G-marco96/DCI/Documentos/Subpartes/Capturas/Ejemplos/Captura CAN.PNG

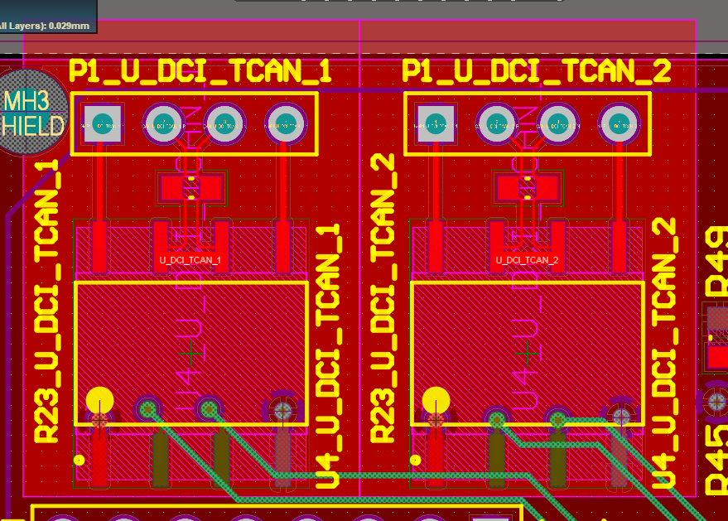
Documentos/Subpartes/Capturas/Ejemplos/Captura CAN.PNG
