G-marco96/DCI/Documentos/Subpartes/Capturas/Captura rooms.PNG

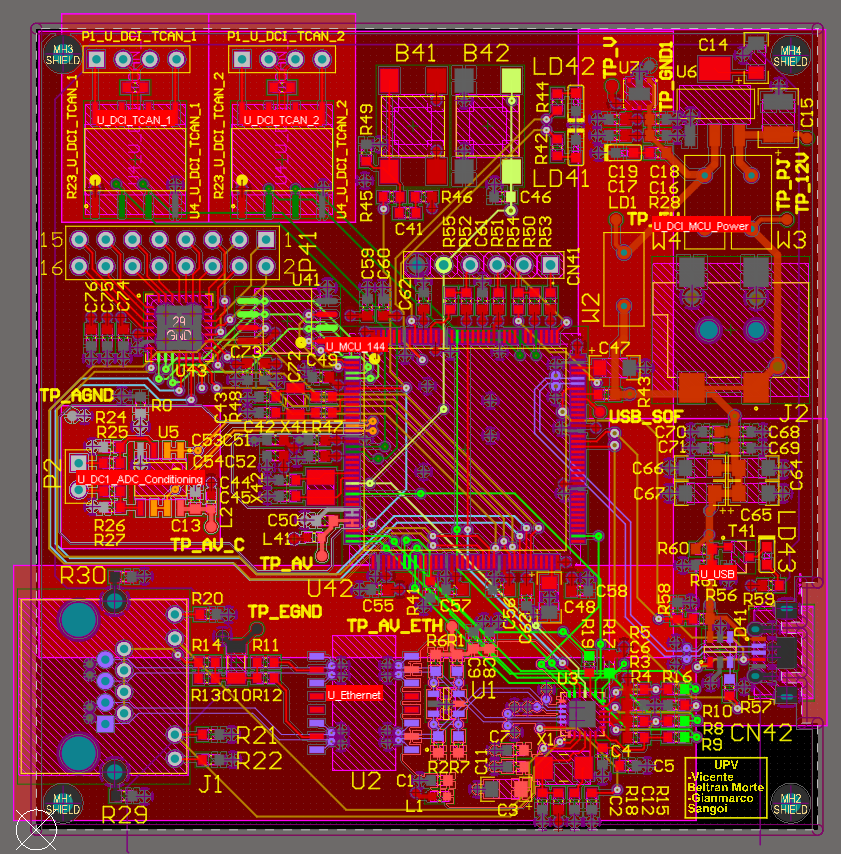
Documentos/Subpartes/Capturas/Captura rooms.PNG
