G-marco96/DCI/README.md

# Master en Sisemas Electronicos (Digital)

Materia: Diseño de Cirucitos Impresos (DCI)

Proyecto: Proyecto final de curso

Integrantes: Gianmarco Sangoi y Vicent Beltrán 

Fecha de inicio: 5/14/2022
