G-marco96/DCI/en.nucleo_144pins_sch/NUCLEO-144pins_Altium_Schematics-Layout/Project Outputs for Nucleo_144/DCI_MB1137.xls

Board Stack Report
Stack Up |  | Layer Stack
Layer | Board Layer Stack | Name | Material | Thickness | Constant
1 |  | Top Paste
2 |  | Top Overlay
3 |  | Top Solder | SM-001 | 0,025mm | 4
4 |  | Top Layer | Copper | 0,018mm
5 |  | Dielectric 2 | PP-018 | 0,152mm | 4,3
6 |  | GND | Copper | 0,035mm
7 |  | Dielectric 3 | Core-028 | 0,254mm | 4,3
8 |  | Top Internal | Copper | 0,018mm
9 |  | Dielectric 4 | PP-017 | 0,130mm | 4,3
10 |  | Dielectric 5 | PP-017 | 0,130mm | 4,3
11 |  | Bottom Internal | Copper | 0,018mm
12 |  | Dielectric 6 | Core-028 | 0,254mm | 4,3
13 |  | VDD | Copper | 0,035mm
14 |  | Dielectric 7 | PP-018 | 0,152mm | 4,3
15 |  | Bottom Layer | Copper | 0,018mm
16 |  | Bottom Solder | SM-001 | 0,025mm | 4
17 |  | Bottom Overlay
18 |  | Bottom Paste
 | Height : 1,263mm
