G-marco96/DCI/Documentos/6layers_1.6mm_LabCode424.pdf

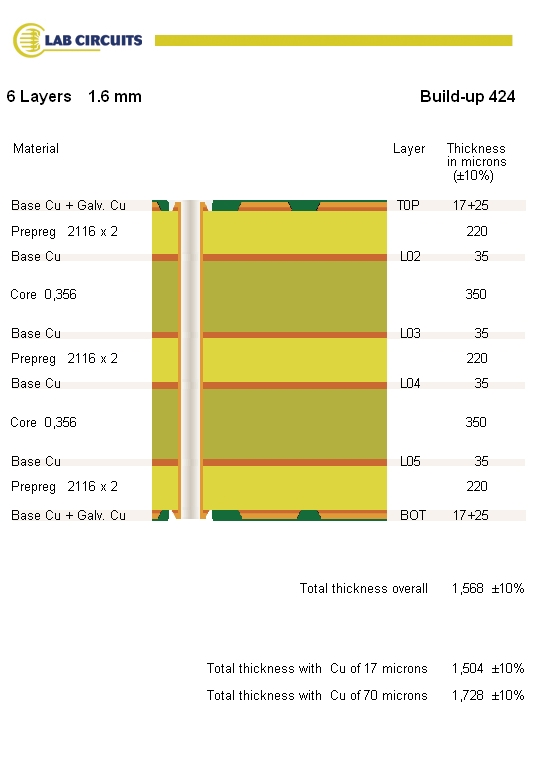
[picture p35: page 1]
