G-marco96/DCI/Documentos/Subpartes/Capturas/Captura Forma placa.PNG

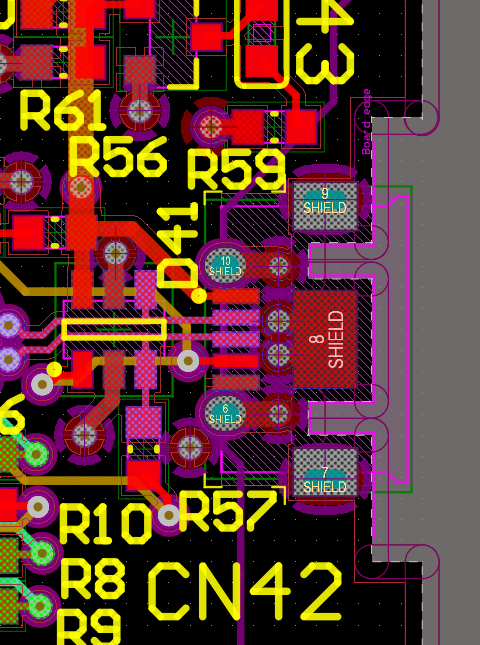
Documentos/Subpartes/Capturas/Captura Forma placa.PNG
