G-marco96/DCI/Documentos/Subpartes/Capturas/Captura Layer 3D.PNG

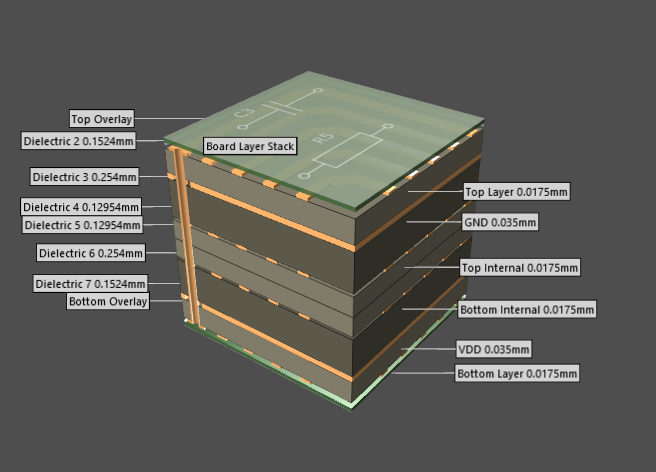
Documentos/Subpartes/Capturas/Captura Layer 3D.PNG
