G-marco96/DCI/Documentos/Subpartes/Capturas/Captura VDD.PNG

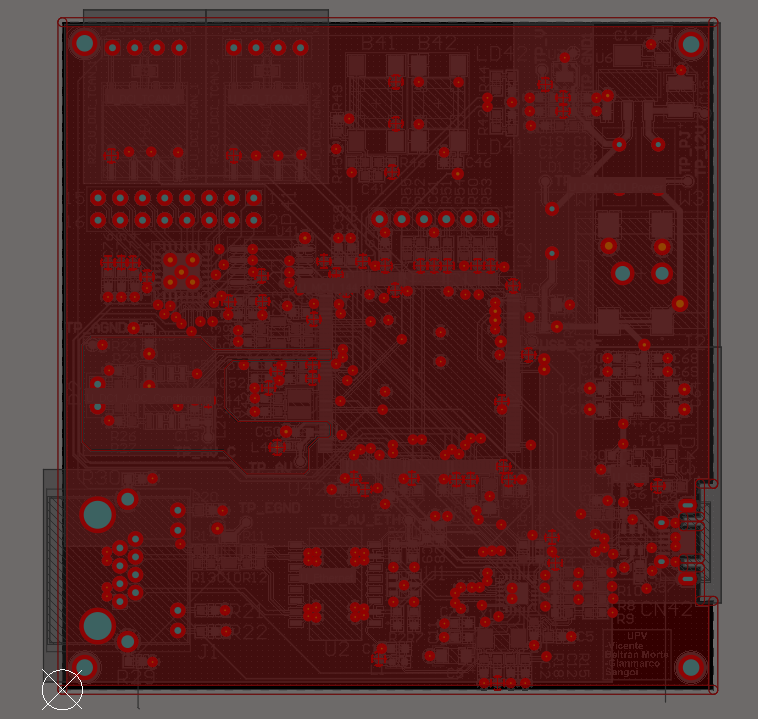
Documentos/Subpartes/Capturas/Captura VDD.PNG
