G-marco96/DCI/Documentos/Subpartes/Capturas/Ejemplos/Captura condensador modificado.PNG

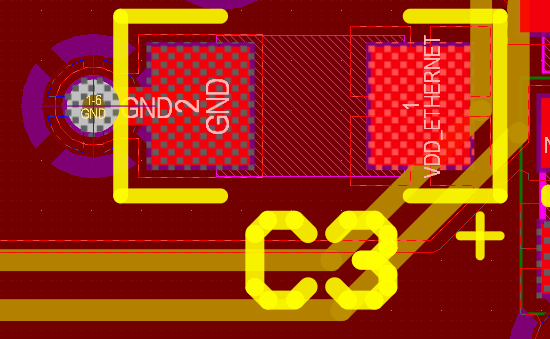
Documentos/Subpartes/Capturas/Ejemplos/Captura condensador modificado.PNG
