G-marco96/DCI/Documentos/Subpartes/Capturas/Ejemplos/Captura Label style.PNG

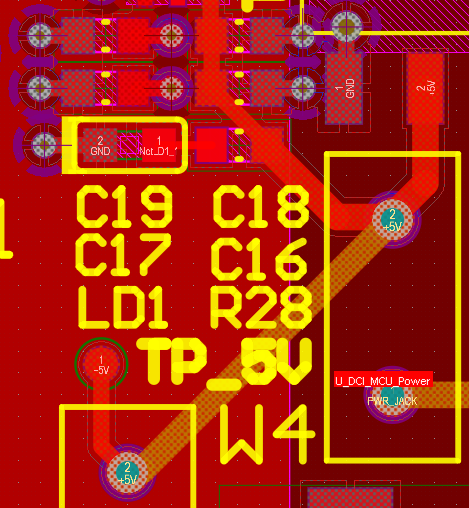
Documentos/Subpartes/Capturas/Ejemplos/Captura Label style.PNG
