G-marco96/DCI/Documentos/Subpartes/Capturas/Ejemplos/Captura vias u43.PNG

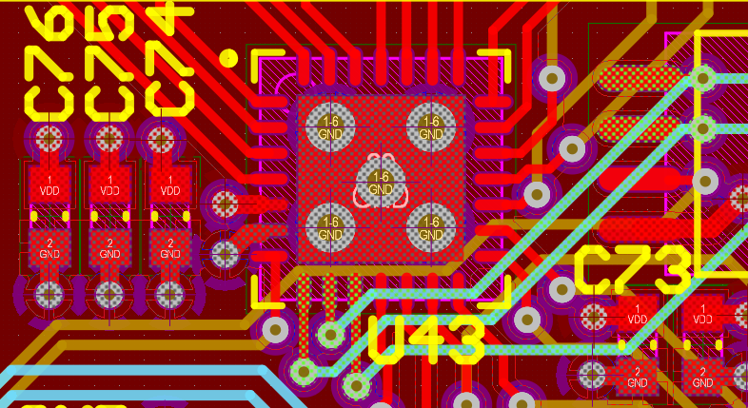
Documentos/Subpartes/Capturas/Ejemplos/Captura vias u43.PNG
