G-marco96/DCI/Documentos/Subpartes/Capturas/Texto sacrificable.PNG

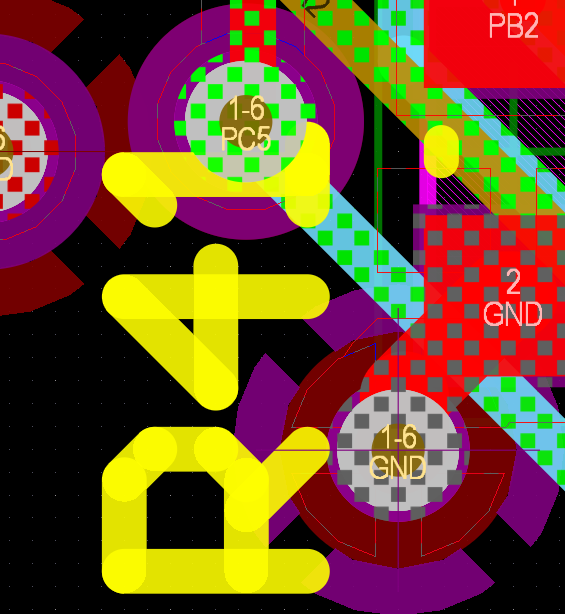
Documentos/Subpartes/Capturas/Texto sacrificable.PNG
