G-marco96/DCI/en.nucleo_144pins_sch/NUCLEO-144pins_Altium_Schematics-Layout/Project Outputs for Nucleo_144/BillOfMaterials.PDF

Comment | Description | Designator | Footprint | LibRef | Quantity
USER (Blue) | SE PUSHBUTTON | B41 | PB-6X6mm-Blue | SW PUSHBUTTON | 1
TD-0341 [RESET/Black] | SE PUSHBUTTON | B42 | PB-6X6mm-Black | SW PUSHBUTTON | | 1
100nF | Capacitor 0402 / 0603 / 0805, Capacitor | C1, C6, C7, C8, C9, C11, C13, C18, C19, C46, C50, C51, C52, C53, C54, C55, C56, C57, C58, C59, C60, C61, C62, C68, C69, C70, C71, C72, C73, C74, C75 | 0603C | Capacitor_ST, Cap | 31
30pF | Capacitor 0402 / 0603 / 0805 | C2, C12 | 0603C | Capacitor_ST | | 2
10uF | Polarized Capacitor,10uF,10V,1 0%,typeA,VISHAY, Polarized Capacitor (Radial) | C3, C14 | TAN-A - XDown | Cap_10uF_POL_10%_ TANA, Cap Pol1 | | 2
470pF | Capacitor 0402 / 0603 / 0805 | C4 | 0603C | Capacitor_ST | | 1
1uF_X5R | 0603 X5R 1µF | C5, C16, C17, C49 | 0603C | CAP SMD 0603 X5R 1µF 25V 10% | | 4
TC1206KKX7RDBB102 | Capacitor 0402 / 0603 / 0805/ 1206 | C10 | 1206C | Capacitor_ST | | 1
10uF(25V) | Polarized Capacitor (Radial) | C15 | TAN-B | Cap Pol1 | | 1
[N/A] | Capacitor | C41 | 0603C | CAP | | 1
2pF | Capacitor | C42, C43 | 0603C | CAP | | 2
4.3pF[N/A] | Capacitor | C44, C45 | 0603C | CAP | | 2
2.2uF_X7R | Capacitor,2.2uF,16V, X7R,10%,0805,YAGEO | C47 | TAN-A - XDown | Cap_2.2uF_X7R_10%_ 0805 | | 1
2.2uF_X7R | Capacitor,2.2uF,16V, X7R,10%,0805,YAGEO | C48 | TAN-A - XUp | Cap_2.2uF_X7R_10%_ 0805 | | 1
4.7uF_X5R_0603 | 0603 X5R 4.7uF | C63, C76 | 0603C | CAP SMD 0603 X5R 1µF 25V 10% | | 2
4.7uF | Polarized Capacitor (Radial) | C64, C66 | TAN-A - XNo | Cap Pol1 | | 2
4.7uF | Polarized Capacitor (Radial) | C65 | TAN-A - XUp | Cap Pol1 | | 1
4.7uF | Polarized Capacitor (Radial) | C67 | TAN-A - XDown | Cap Pol1 | | 1
SWD_Header | Header, 6-Pin, Single row | CN41 | HDR_1x6_2R54_V_M | Header 6X1 | | 1
475900001 | | CN42 | MOLEX_47590001 | 475900001 | | 1
ESDA6V1BC6 | 4-line ESD protection | D41 | SOT23-6L | ESDA6V1BC6 | | 1
RJHSE-5381 | High Speed RJ45, Modular Jack, 8 Position, 8 Contacts, Shielded, with LEDs, -55 to 85 degC,12-Pin THD, RoHS, Tray | J1 | AMPH-RJHSE-5381_V | CMP-2000-06980-1 | | 1
Power_Connector | DC Power Jack, Right Angle, -25 to 85 degC, 4-Pin 14.8 x 9 x 11mm SMD, RoHS, Tape and Reel | J2 | CUI-PJ-002AH-4_V | CMP-2000-06896-1 | | 1
BEAD | Inductor | L1, L2, L41 | 0603L | Inductor | | 3
Green | Typical RED, GREEN, YELLOW, AMBER GaAs LED | LD1, LD43 | 0603D-G | LED2 | | 2
Blue | Typical RED, GREEN, YELLOW, AMBER GaAs LED | LD41 | 0603D-B | LED2 | | 1
Red | Typical RED, GREEN, YELLOW, AMBER GaAs LED | LD42 | 0603D-R | LED2 | | 1
CAN_Header | Header, 4-Pin | P1_U_DCI_TCAN_1, P1_U_DCI_TCAN_2 | HDR1X4 | Header 4 | | 2
ADC_Header | Header, 2-Pin | P2 | HDR1X2 | Header 2 | | 1
Header 8X2 | Header, 8-Pin, Dual row | P41 | HDR2X8 | Header 8X2 | | 1
0 | Resistor, Resistor 0402 / 0603 / 0805 | R0, R29, R30, R47, R48, R53 | 0603R | res1, Resistor_ST | | 6
50 | Resistor,50,0603,1%,Y AGEO | R1, R2, R6, R7 | 0603R | Res_50_1%_0603 | | 4
10K | Resistor 0402 / 0603 / 0805, Resistor | R3, R4, R5, R10, R18, R21, R25, R27, R43, R50, R51, R52 | 0603R | Resistor_ST, Res1 | 12
33 | Resistor,33,0402,1%,Y AGEO | R8, R9, R16, R19 | 0603R | Res_33_1%_0402 | | 4
75 | Resistor,75,0603,1%,Y AGEO | R11, R12, R13, R14 | 0603R | Res_75_1%_0603 | | 4
12K1 | Resistor,12K1,0603,1 %,VISHAY | R15 | 0603R | Res_12K1_1%_0603 | | 1
1K5 | Resistor,1K5,0402,1%, YAGEO, Resistor 0402 / 0603 / 0805 | R17, R57 | 0603R | Res_1K5_1%_0402, Resistor_ST | | 2
270 | Resistor 0402 / 0603 / 0805 | R20, R22 | 0603R | Resistor_ST | | 2
120 | Resistor | R23_U_DCI_TCAN_1, R23_U_DCI_TCAN_2 | 0603R | Res1 | | 2
22K | Resistor | R24, R26, R61 | 0603R | Res1 | | 3
1K | Resistor 0402 / 0603 / 0805, Resistor | R28, R44 | 0603R | Resistor_ST, Res1 | | 2
100K | Resistor | R41 | 0603R | res1 | | 1
680 | Resistor | R42 | 0603R | Res1 | | 1
330 | Resistor | R45, R59 | 0603R | Res1 | | 2
100 | Resistor | R46 | 0603R | Res1 | | 1
220K | Resistor | R49 | 0603R | res1 | | 1
22 | Resistor 0402 / 0603 / 0805 | R54, R55 | 0603R | Resistor_ST | | 2
430K | Resistor | R56 | 0603R | res1 | | 1
620K | Resistor | R58 | 0603R | res1 | | 1
47K | Resistor | R60 | 0603R | res1 | | 1
9013 | NPN Bipolar Transistor | T41 | SOT-23 | NPN | | 1
TP_5V | | TP_5V | TP | TP | | 1
TP_12V | | TP_12V | TP | TP | | 1
TP_AGND | | TP_AGND | TP | TP | | 1
TP_AVDD | | TP_AV | TP | TP | | 1
TP_AVDD_C | | TP_AV_C | TP | TP | | 1
TP_AVDD_ETH | | TP_AV_ETH | TP | TP | | 1
TP_EGND | | TP_EGND | TP | TP | | 1
TP_GND | | TP_GND1 | TP | TP | | 1
TP_PJ | | TP_PJ | TP | TP | | 1
TP_VDD | | TP_V | TP | TP | | 1
USBLC6-4SC6 | | U1 | SOT23-6L | USBLC6-4SC6 | | 1
KMS-1102NL | | U2 | Transformer | KMS-1102NL | | 1
LAN8742A-CZ-TR | LAN8742A-CZ-TR -Small Footprint RMII 10/100 Ethernet, Transceiver with HP Auto-MDIX and flexPWR Technology SQFN-24 | U3 | QFN24_0R5_4X4 | LAN8742A-CZ-TR | | 1
ISO1050DUBR | Isolated CAN Transceiver, -55 to 105 degC, 8-pin SOP (DUB), Green (RoHS & no Sb/Br) | U4_U_DCI_TCAN_1, U4_U_DCI_TCAN_2 | DUB0008A_L | CMP-0315-00093-2 | | 2
MC33077DR2G | Low Noise Dual Operational Amplifier, 5 to 36 V, -40 to 85 degC, 8-Pin SOIC, Pb-Free, Tape and Reel | U5 | ONSC-SOIC-8-751-07_V | CMP-1310-00366-1 | | 1
LD1117S50TR | | U6 | SOT-223 | LD1117 | | 1
LD39050PU33R | | U7 | DFN6_0R95_3x3_TP | LD39050P | | 1
M25P16-VMW6G | 16 Mb (x1) Serial NOR Flash Memory, 75 MHz, 2.7 to 3.6 V, 8-pin SO8 Wide (MW), Tube | U41 | MICT-MW-8_N | CMP-0357-00145-1 | | 1
MCU_LQFP144 | | U42 | TSQFP50P2200X2200X 160-144N | MCU_LQFP144 | | 1
MCP23S17T-E/ML | 16 output GPIO expander | U43 | QFN-ML28_L-Improved_Holes | MCP23S17T-E/ML | | 1
USB_SOF | | USB_SOF | TP | TP | | 1
Jumper_USB | Jumper Wire | W2 | RAD-0.2 | Jumper | | 1
Jumper_12V | Jumper Wire | W3 | RAD-0.2 | Jumper | | 1
Jumper_5V | Jumper Wire | W4 | RAD-0.2 | Jumper | | 1
X53T-C20SSA-25.000MHz | Crystal Oscillator | X1 | XTAL_2SM_5R0X3R2 | XTAL_5032 | | 1
NX3215SA-32.768KHZ | Crystal | X41 | XTAL_2SM_3R2X1R5 | CRYSTAL_32K | | 1
NX3225GD-8.000M-EXS00A | Crystal Oscillator | X42 | OSC_2SM_3R2x2R5 | XTAL | | 1
