G-marco96/DCI/en.nucleo_144pins_sch/NUCLEO-144pins_Altium_Schematics-Layout/Project Outputs for Nucleo_144/Drills.PDF

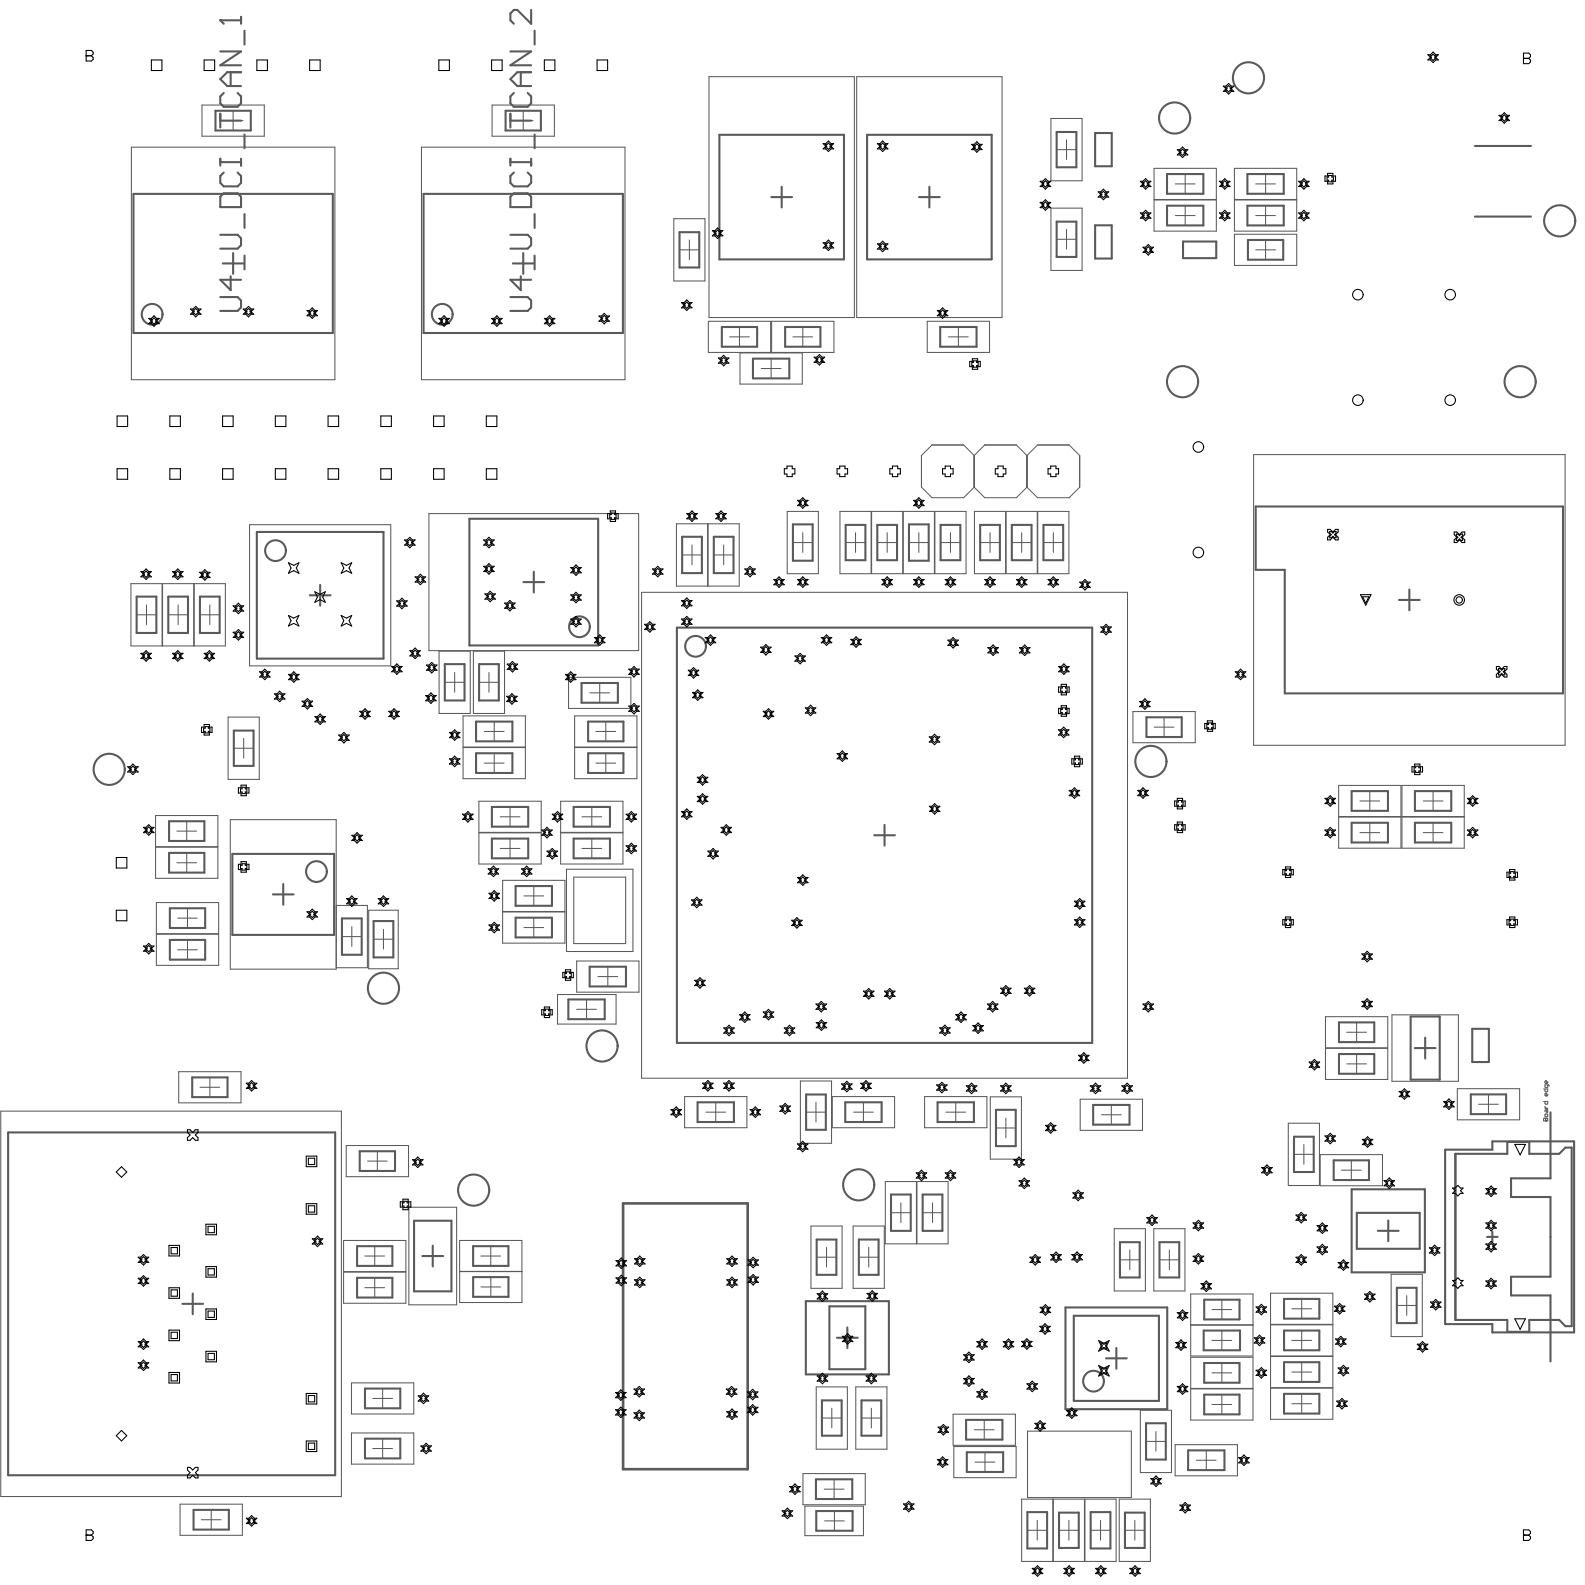
[picture p51: page 1]

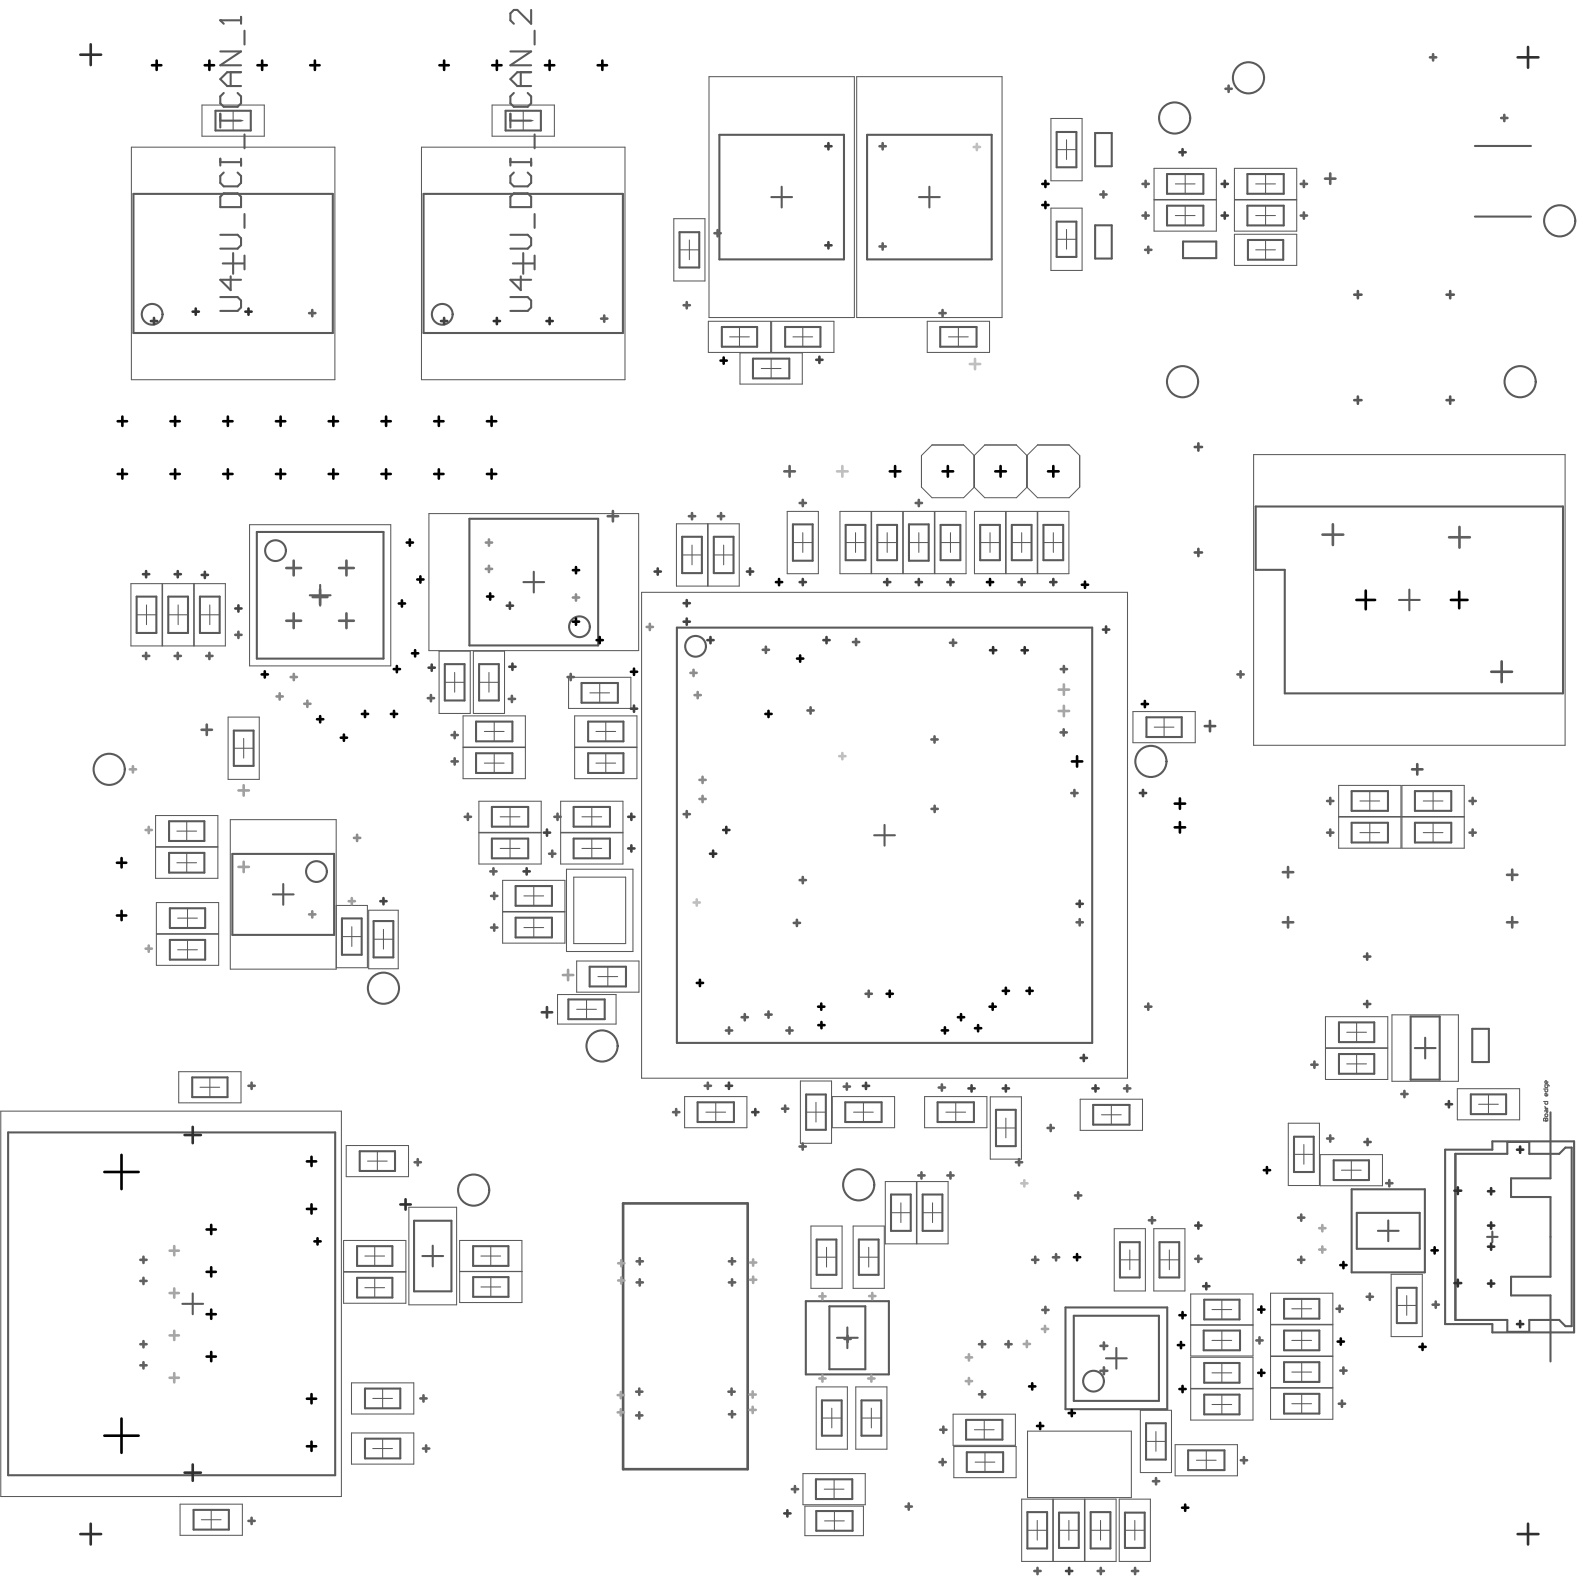
[picture p52: page 2]
