G-marco96/DCI/en.nucleo_144pins_sch/NUCLEO-144pins_Altium_Schematics-Layout/Project Outputs for Nucleo_144/PCB3D.PDF

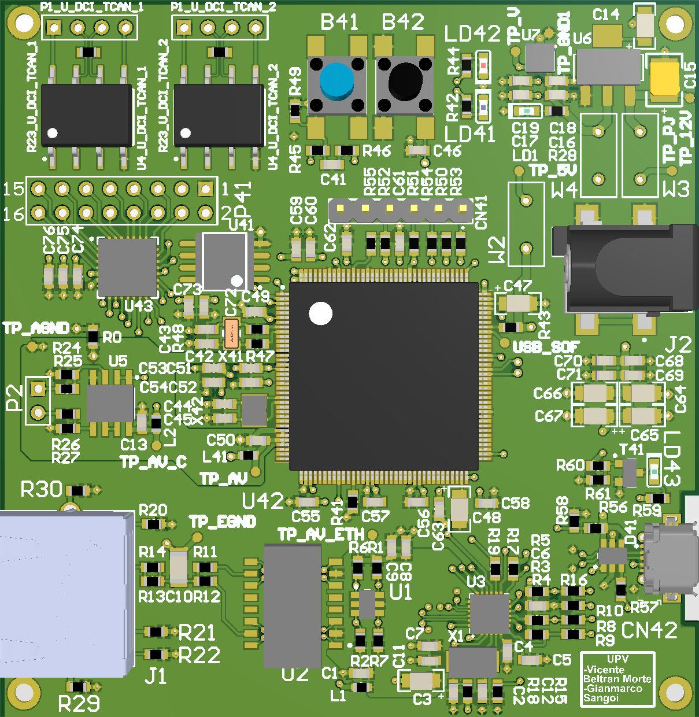
[picture p53: page 1]
