G-marco96/DCI/(list of files, drawings)

Other design files:
en.nucleo_144pins_sch/NUCLEO-144pins_Altium_Schematics-Layout/DC1_ADC_Conditioning.SchDoc
en.nucleo_144pins_sch/NUCLEO-144pins_Altium_Schematics-Layout/DCI_Ethernet.SchDoc
en.nucleo_144pins_sch/NUCLEO-144pins_Altium_Schematics-Layout/DCI_MB1137.PcbDoc
en.nucleo_144pins_sch/NUCLEO-144pins_Altium_Schematics-Layout/DCI_MB1137.PcbLib
en.nucleo_144pins_sch/NUCLEO-144pins_Altium_Schematics-Layout/DCI_MB1137.PrjPCB
en.nucleo_144pins_sch/NUCLEO-144pins_Altium_Schematics-Layout/DCI_MB1137.SchDoc
en.nucleo_144pins_sch/NUCLEO-144pins_Altium_Schematics-Layout/DCI_MB1137.SCHLIB
en.nucleo_144pins_sch/NUCLEO-144pins_Altium_Schematics-Layout/DCI_MCU_144.SchDoc
en.nucleo_144pins_sch/NUCLEO-144pins_Altium_Schematics-Layout/DCI_MCU_Power.SchDoc
en.nucleo_144pins_sch/NUCLEO-144pins_Altium_Schematics-Layout/DCI_TCAN.SchDoc
en.nucleo_144pins_sch/NUCLEO-144pins_Altium_Schematics-Layout/DCI_USB.SchDoc
