G-marco96/DCI/(commit log)

2022-05-18 Descarga de archivos
    [Connectors.SchDoc, Ethernet.SchDoc, MB1137.PcbLib, MB1137.PrjPCB, MB1137.SCHLIB, MB1137.SchDoc, MCU_144.SchDoc, ST_LINK_V2-1.SCHDOC]
2022-05-19 zocalo and RJ45 check
    [Connectors.SchDoc, DCI_Connectors.SchDoc, DCI_Ethernet.SchDoc, DCI_MB1137.PcbLib, DCI_MB1137.PrjPCB, DCI_MB1137.SCHLIB, DCI_MB1137.SchDoc, DCI_MCU_144.SchDoc]
2022-05-19 TS-LINK delete, zocalo fix, rj45 change, swd connector
    [DCI_Ethernet.SchDoc, DCI_MB1137.PcbLib, DCI_MB1137.PrjPCB, DCI_MB1137.SCHLIB, DCI_MB1137.SchDoc, DCI_MCU_144.SchDoc, DCI_ST_LINK_V2-1.SCHDOC, DCI_TCAN_ADC.SchDoc]
2022-05-21 Esquemáticos acabados
    -Expansor de pines
    -CAN
    -Condicionamiento ADC
    -Memoria SPI
    [DC1_ADC_Conditioning.SchDoc, DCI_Connectors.SchDoc, DCI_MB1137.PrjPCB, DCI_MB1137.SchDoc, DCI_MCU_144.SchDoc, DCI_TCAN.SchDoc, DCI_TCAN_ADC.SchDoc, DCI_USB.SchDoc]
2022-05-21 Resubida de la anterior (no subí todos los cambios))
2022-05-25 Solved errors (or placed No ERC directives)
    [DCI_MB1137.PrjPCB, DCI_MB1137.SCHLIB, DCI_MB1137.SchDoc, DCI_MCU_144.SchDoc, DCI_USB.SchDoc]
2022-05-31 enttrega del 29
    [DCI_Connectors.SchDoc, DCI_Ethernet.SchDoc, DCI_MB1137.PrjPCB, DCI_MB1137.SchDoc, DCI_MCU_144.SchDoc, DCI_USB.SchDoc]
2022-06-15 Correciones
    -Errores
    -Casi todos los warnings (la mayoría con DRCs)
    -DAC en 2 módulos individuales
    -Power en hoja a parte, cambiado +3V3_PER y +3V3 por VDD
    -Condicionamiento: OPAMP alimentados con AVDD y resistencias de los divisores de tensión de 20k a 22k
    IDEAS: Ferrita y condesador a los opamps y cambiar AVDD por VDD
    [DC1_ADC_Conditioning.SchDoc, DCI_Ethernet.SchDoc, DCI_MB1137.PrjPCB, DCI_MB1137.SchDoc, DCI_MCU_144.SchDoc, DCI_MCU_Power.SchDoc, DCI_TCAN.SchDoc, DCI_USB.SchDoc]
2022-06-16 USB y segerencias anteriores
    -No se proporciona potencia al USB
    -Se puede recibir potencia del USB, 5V directo o hasta 15V (se pueden cortar con jumpers)
    -Filtrado a la entrada de los opamp dobles
    [DC1_ADC_Conditioning.SchDoc, DCI_Ethernet.SchDoc, DCI_MB1137.SchDoc, DCI_MCU_Power.SchDoc, DCI_USB.SchDoc]
2022-06-19 Directives and manufacturing restrictions
    [DCI_MB1137.PcbDoc, DCI_MB1137.PrjPCB, DCI_MCU_Power.SchDoc, DCI_USB.SchDoc]
2022-06-19 Corrección de problemas con ERC y emplazamiento
    Se arreglaron las conexiones que se habian borrado, se volvio a verificar con el ERC y se selecciono las lineas a ignorar.
    Se emplazo y delimito el PCB
    [DC1_ADC_Conditioning.SchDoc, DCI_Ethernet.SchDoc, DCI_MB1137.PcbDoc, DCI_MB1137.PrjPCB, DCI_MB1137.SchDoc, DCI_MCU_144.SchDoc, DCI_MCU_Power.SchDoc, DCI_TCAN.SchDoc]
2022-06-22 Por si me vuelve a petar el SO por 3a vez
    -Emplazamiento y rutado casi acabado
    -Eliminado componentes prescindibles (incluyendo jumpers, que se configuran con resistencias opcionales)
    -Añadido puntos de test
    [DCI_Ethernet.SchDoc, DCI_MB1137 - saved.PcbDoc, DCI_MB1137.PcbDoc, DCI_MB1137.PrjPCB, DCI_MCU_144.SchDoc, DCI_MCU_Power.SchDoc, DCI_TCAN.SchDoc, DCI_USB.SchDoc]
2022-06-24 Cajetin y nombres volteados
    [DC1_ADC_Conditioning.SchDoc, DCI_Ethernet.SchDoc, DCI_MB1137.PcbDoc, DCI_MB1137.SchDoc, DCI_MCU_144.SchDoc, DCI_MCU_Power.SchDoc, DCI_TCAN.SchDoc, DCI_USB.SchDoc]
2022-06-24 pwr netclass select and change a little the board size
    [DCI_MB1137.PcbDoc, DCI_MB1137.PrjPCB]
2022-06-25 Solved alignment errors in schematic due to unit change
    [DC1_ADC_Conditioning.SchDoc, DCI_Ethernet.SchDoc, DCI_MB1137.PcbDoc, DCI_MB1137.SchDoc, DCI_MCU_144.SchDoc, DCI_MCU_Power.SchDoc, DCI_TCAN.SchDoc, DCI_USB.SchDoc]
2022-06-26 Avances rutado y emplazamiento
    [DCI_Ethernet.SchDoc, DCI_MB1137.PcbLib, DCI_MB1137.PrjPCB, DCI_MB1137.SCHLIB, DCI_MCU_144.SchDoc, DCI_MCU_Power.SchDoc, DCI_USB.SchDoc]
2022-06-26 More Routing
    USB
    Fix some GND and VDD vias
    Add GND and VVD vias
    Select the net plane for VDD and GND
    Route some tracks
2022-06-30 Errores de vias y solder mask sliver. Rerutado ligero
    [DCI_Ethernet.SchDoc]
2022-07-04 Stack updated
    [DCI_MB1137.PrjPCB]
2022-07-05 Finish Routing
    16 more errors to eliminated
    [DC1_ADC_Conditioning.SchDoc, DCI_Ethernet.SchDoc, DCI_MB1137.SchDoc, DCI_MCU_144.SchDoc, DCI_MCU_Power.SchDoc, DCI_TCAN.SchDoc, DCI_USB.SchDoc]
2022-07-05 Gerbers, BOM, and other files
    [DCI_MB1137 - saved.PcbDoc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]
2022-07-05 Correcciones y captura rooms
    [DCI_MB1137.PrjPCB]
2022-07-05 BOM, Gerbers, etc
2022-07-05 Gerbers, BOM, etc
    [DCI_MB1137.GBL, DCI_MB1137.GBO, DCI_MB1137.GBP, DCI_MB1137.GBS, DCI_MB1137.GKO, DCI_MB1137.GM1, DCI_MB1137.GTL, DCI_MB1137.GTO]
